wintrmut3/ECE496Hardware/CAD/drawing_1.png

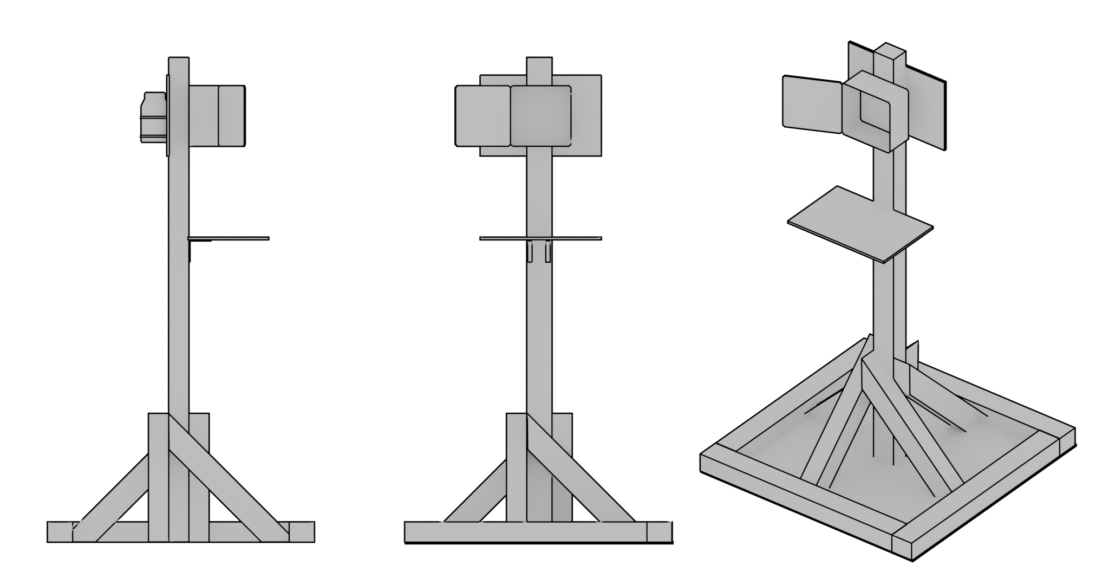
CAD/drawing_1.png
