wintrmut3/ECE496Hardware/(list of files, cad)

Other CAD files:
CAD/post_model.blend
