wintrmut3/ECE496Hardware/layout_v1.pdf

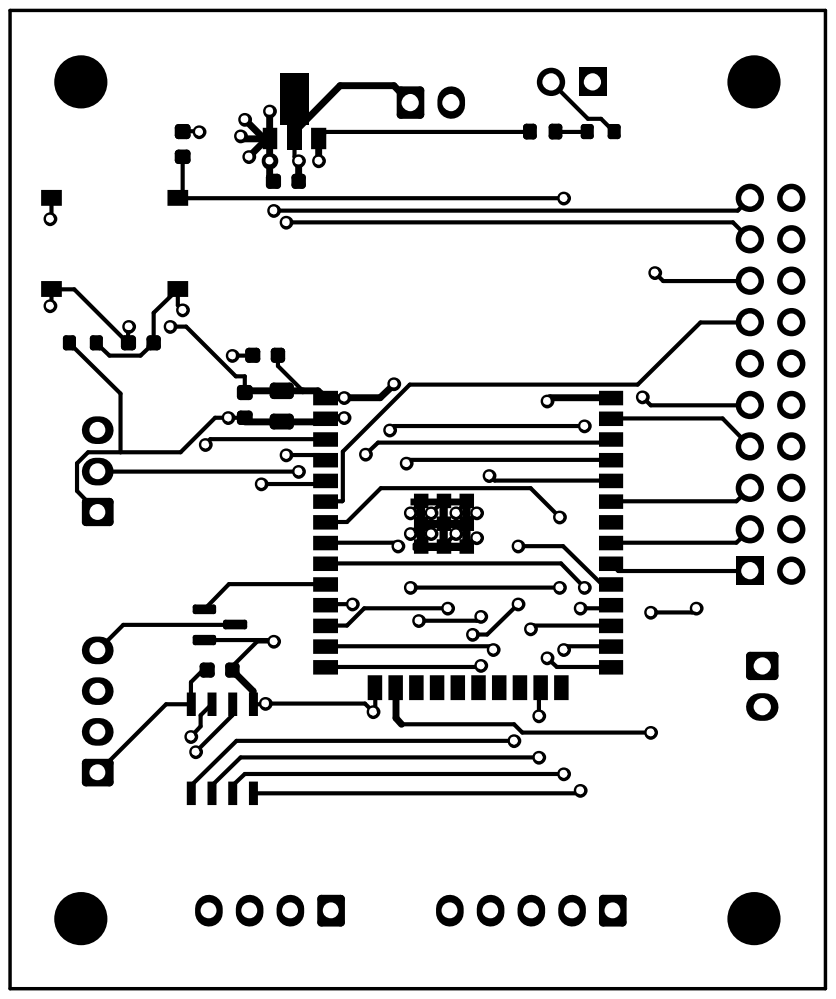
[picture p2: page 1]

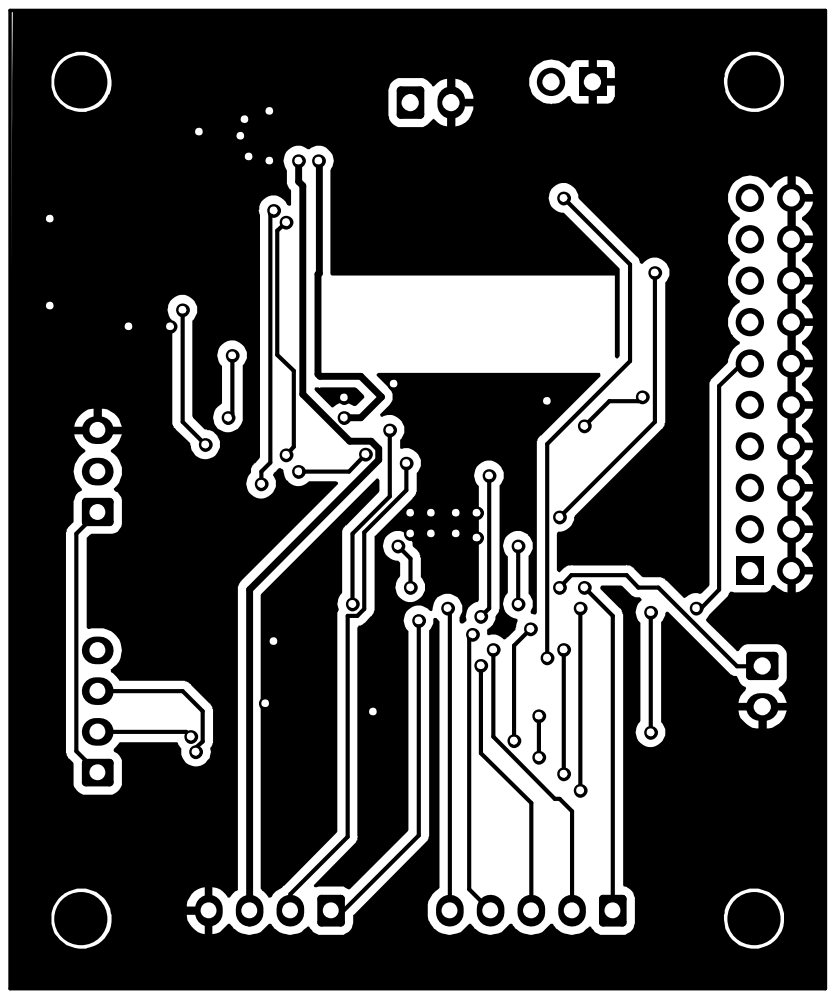
[picture p3: page 2]

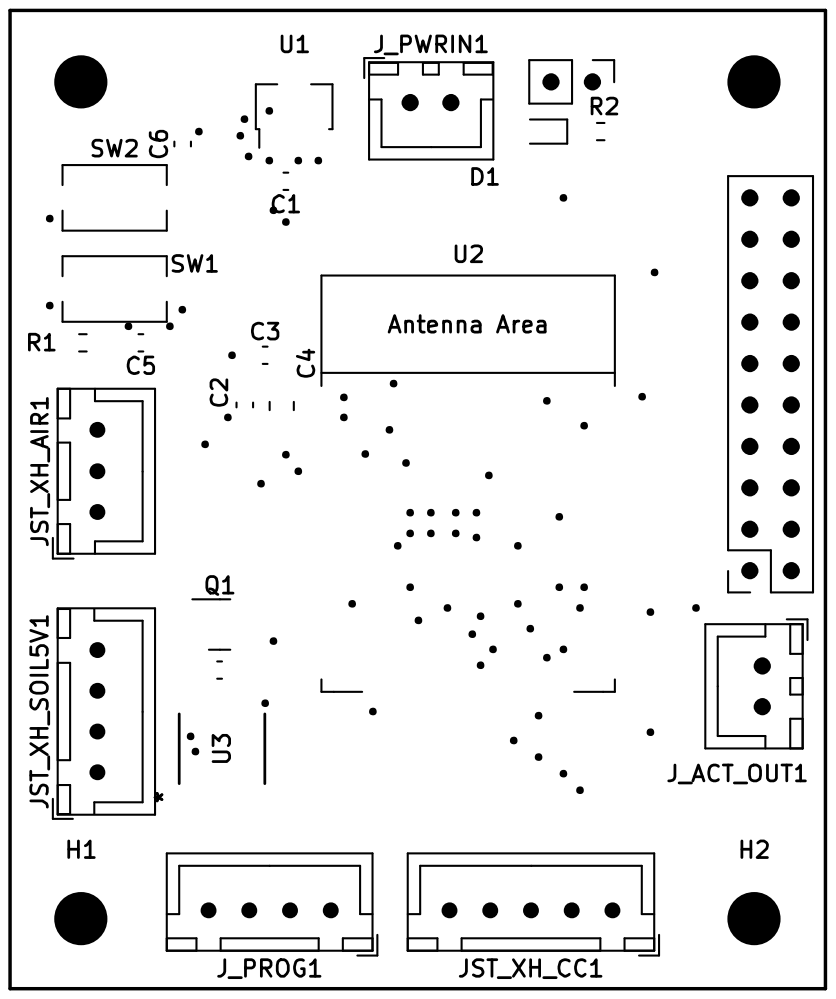
[picture p4: page 5]
