wintrmut3/ECE496Hardware/pcb_v1.pdf

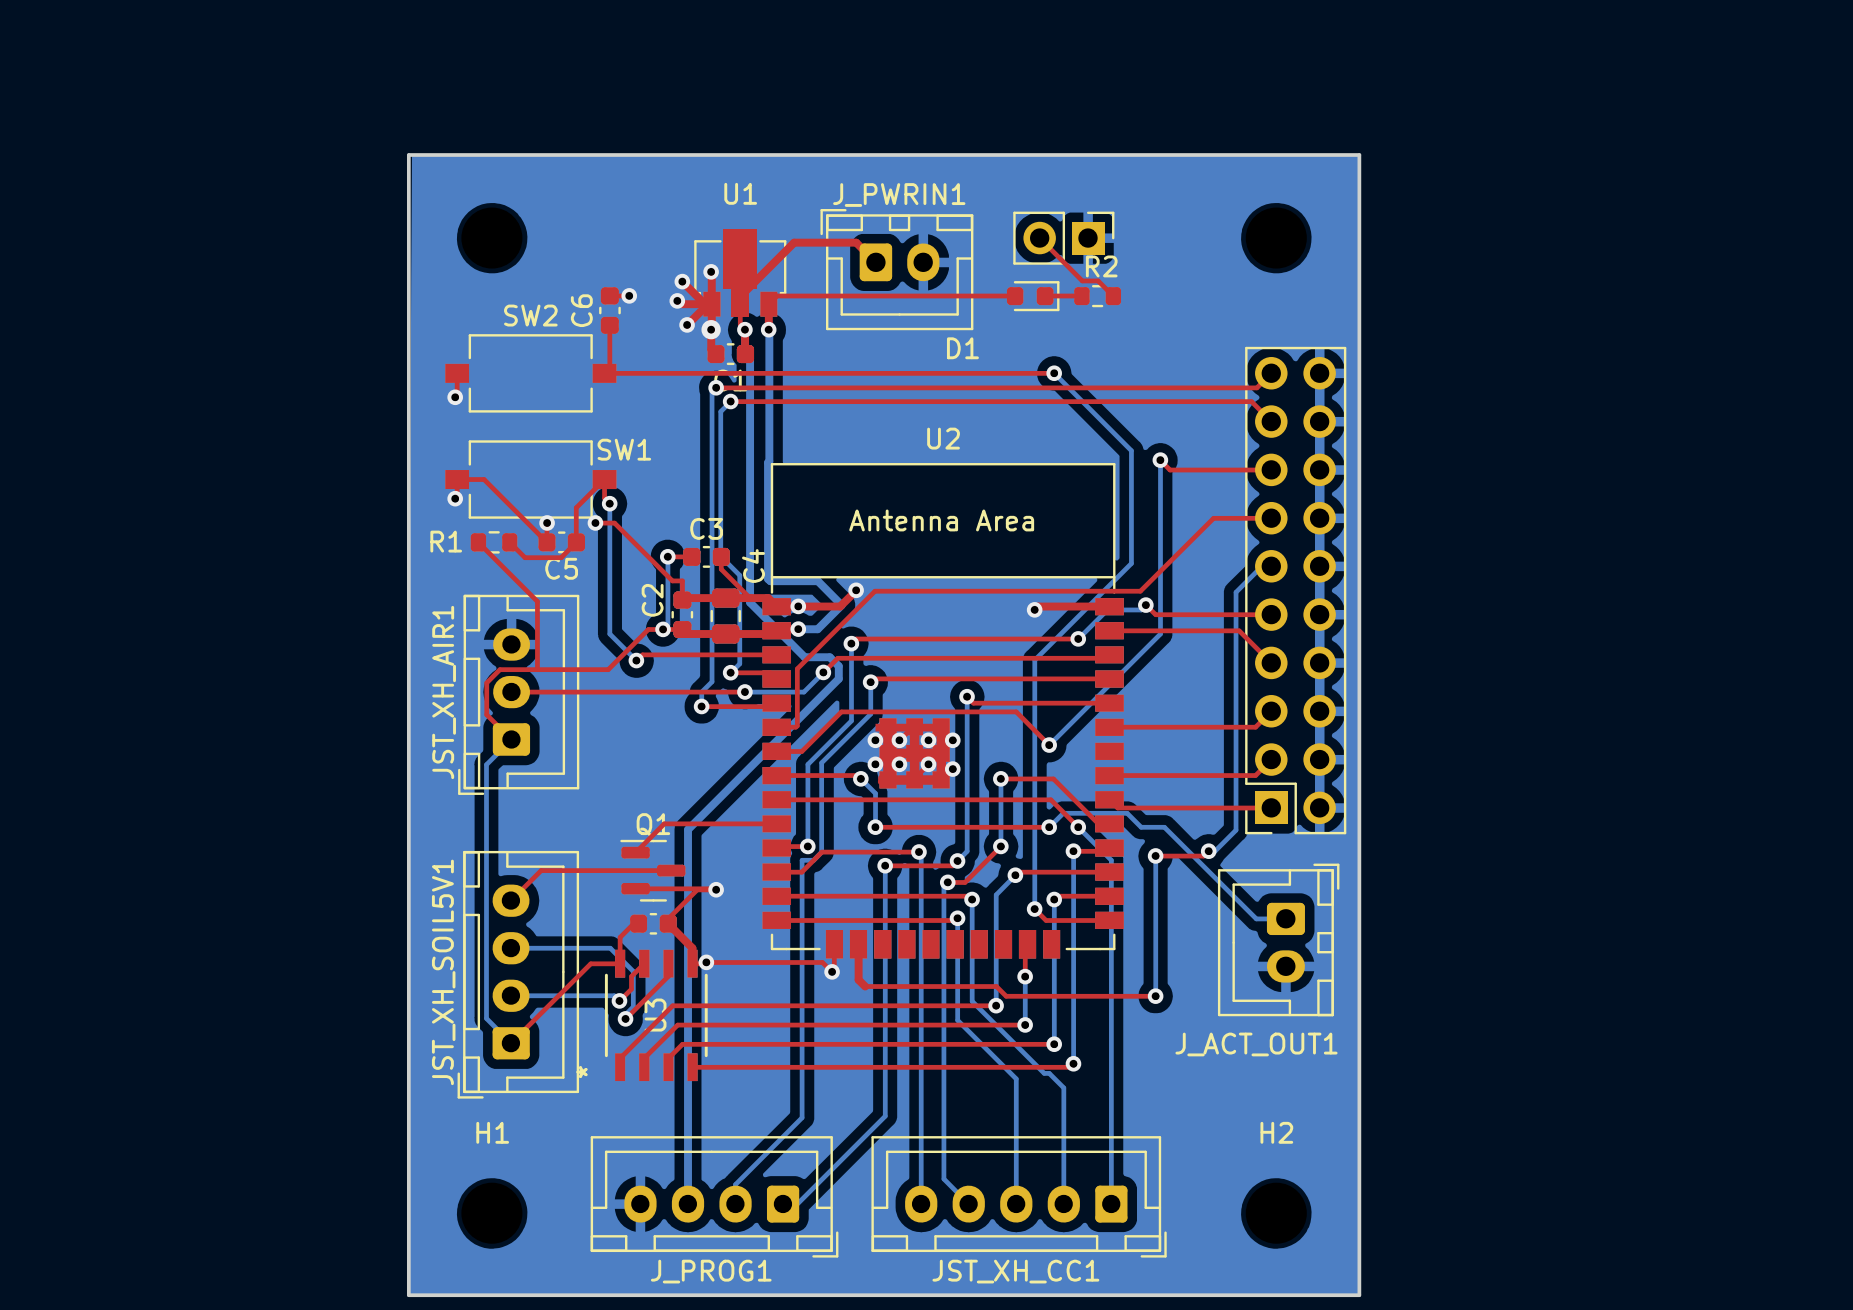
[picture p5: page 1]
