wintrmut3/ECE496Hardware/sch_v2.pdf

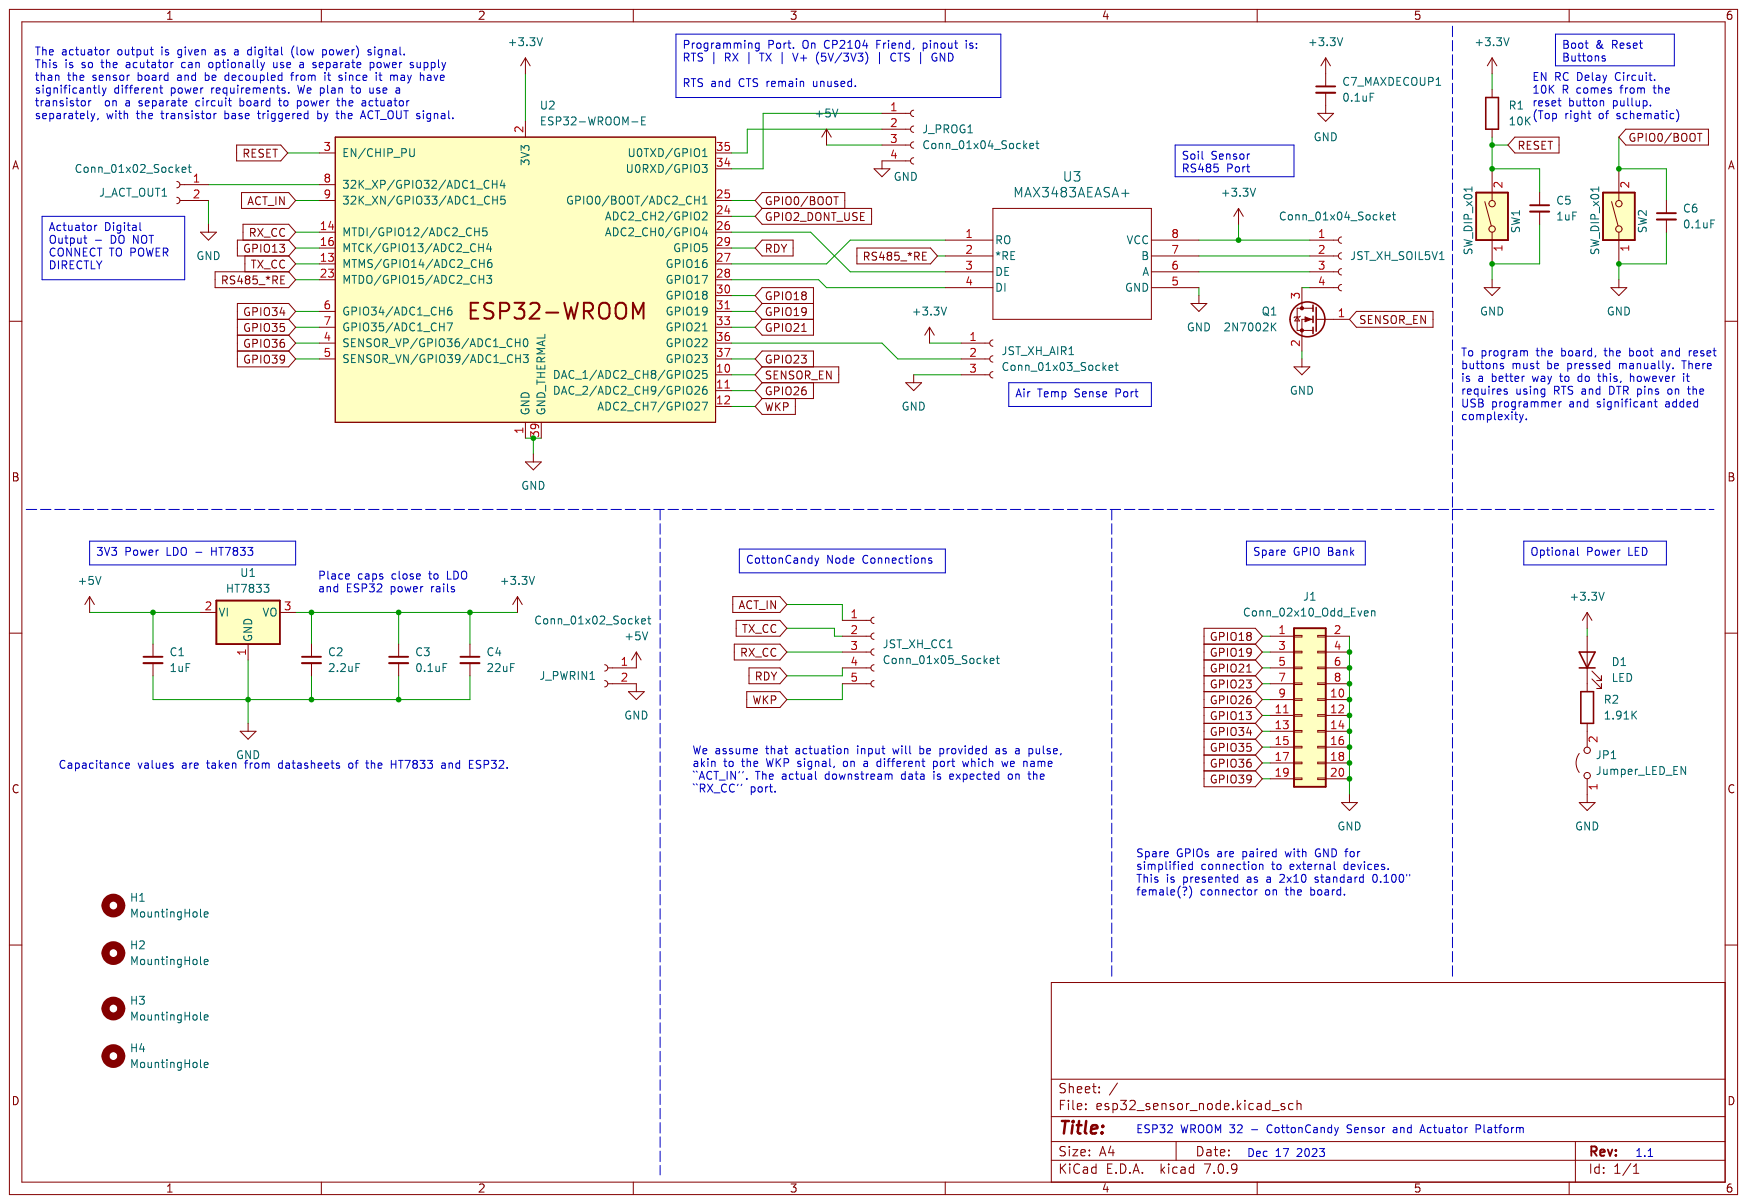
[picture p6: page 1]
