wintrmut3/ECE496Hardware/esp32_sensor_node_pcb/tmp.pdf

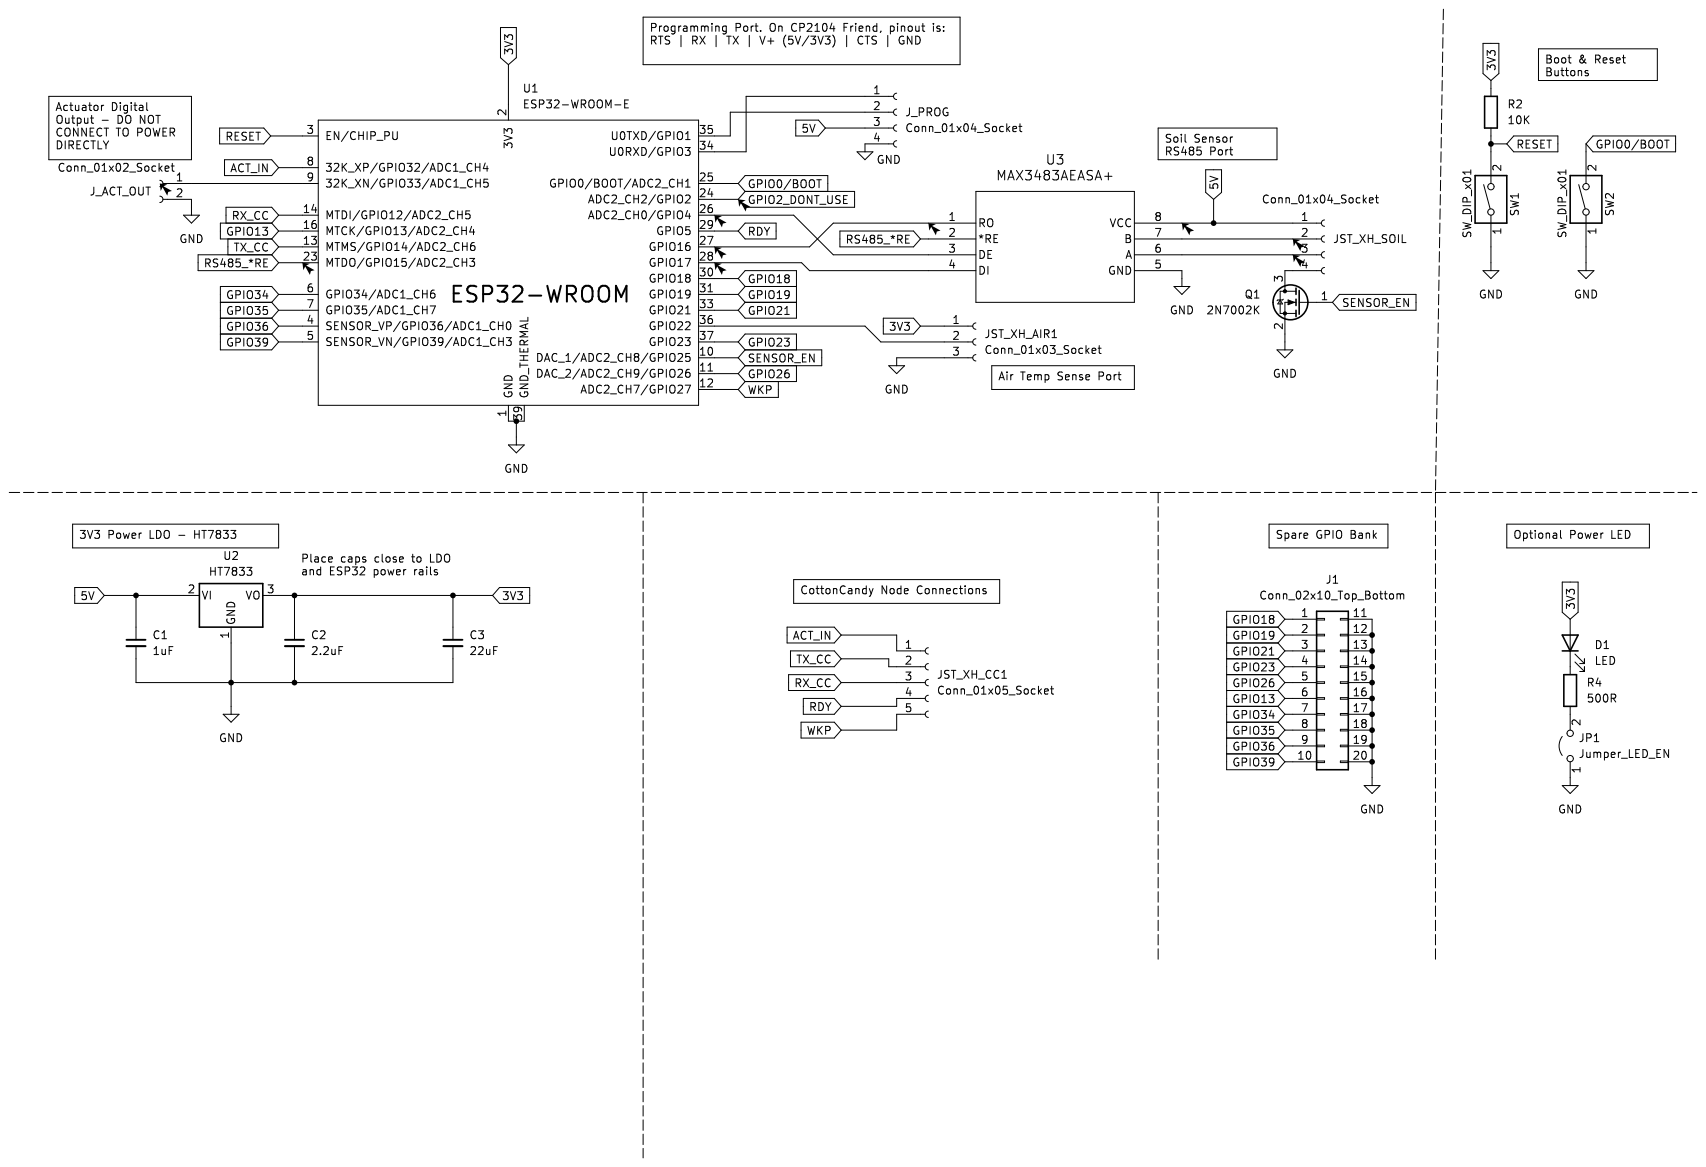
[picture p7: page 1]
