wintrmut3/ECE496Hardware/sch_v1.pdf

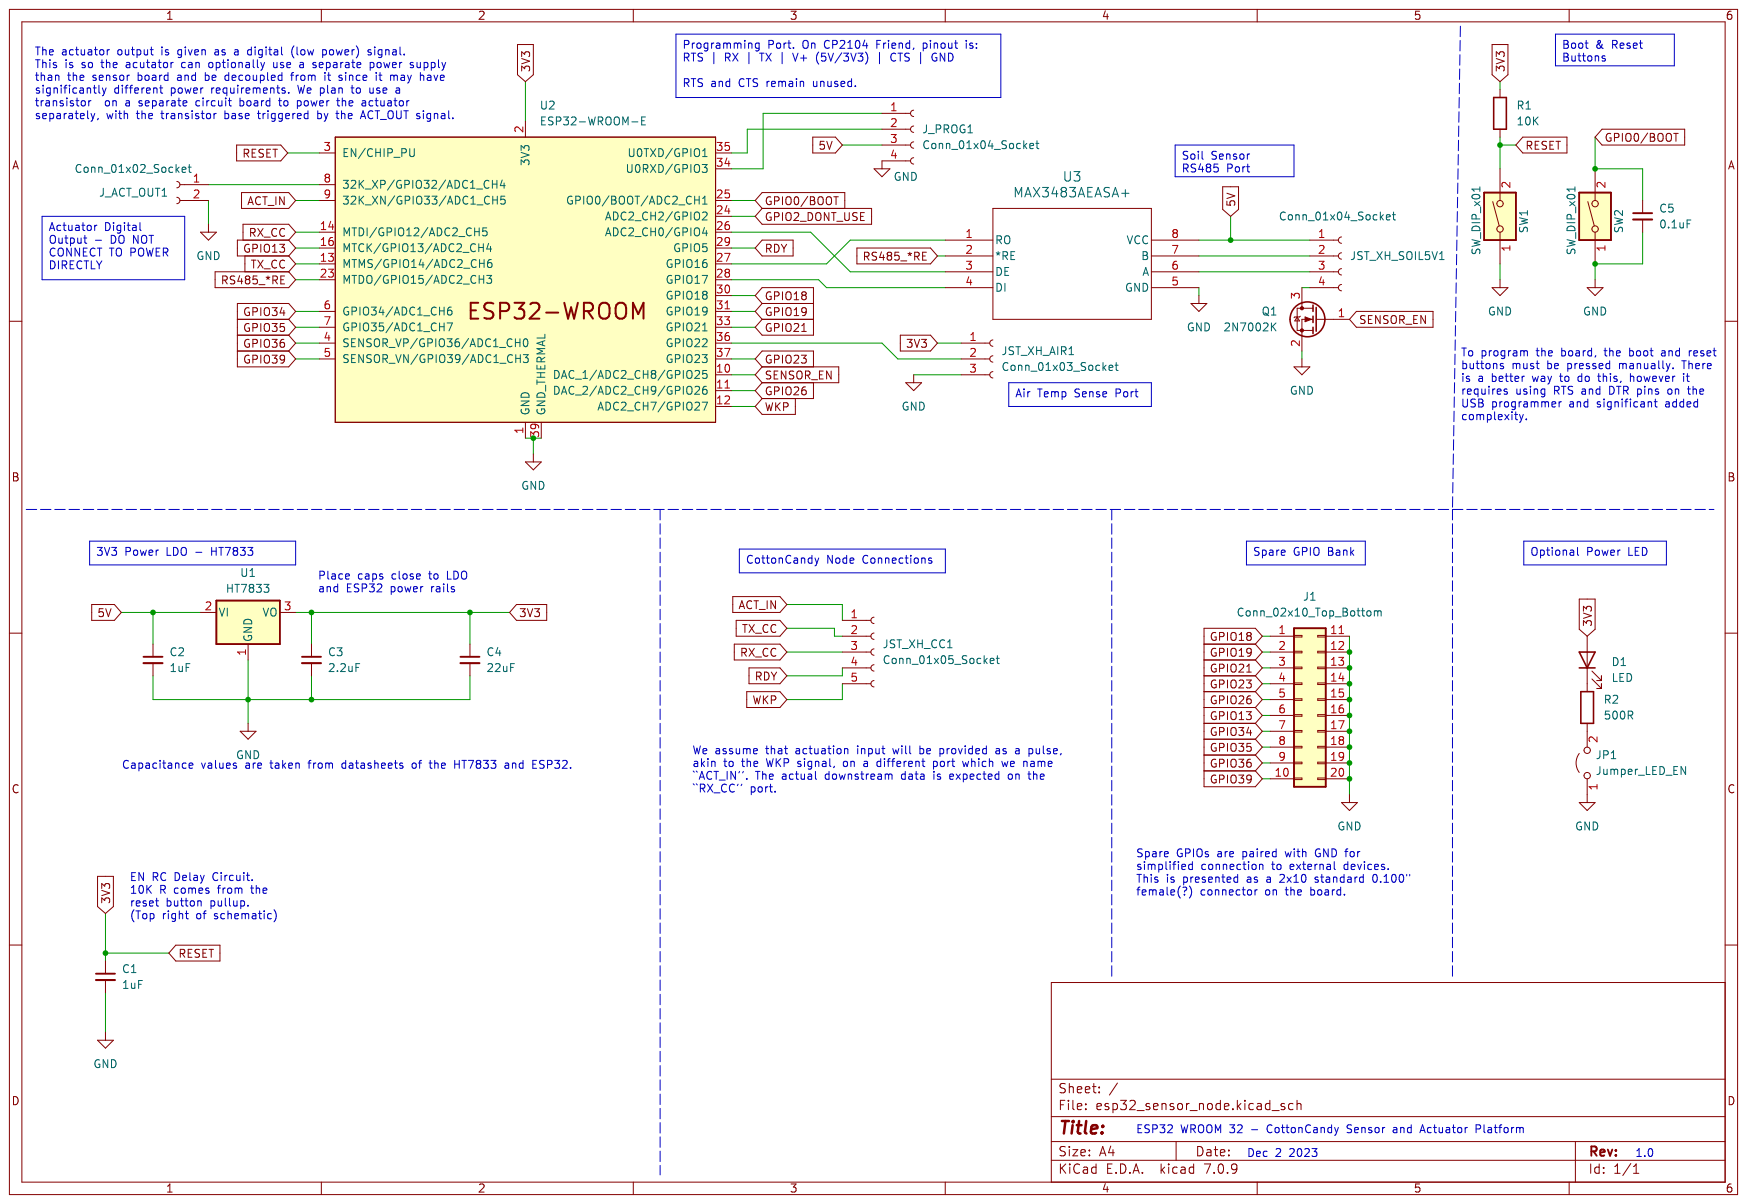
[picture p8: page 1]
