wintrmut3/ECE496Hardware/esp32_sensor_node_pcb/esp32_sensor_node.kicad_pcb

## KiCad design esp32_sensor_node_pcb/esp32_sensor_node.kicad_pcb (2023-12-28)

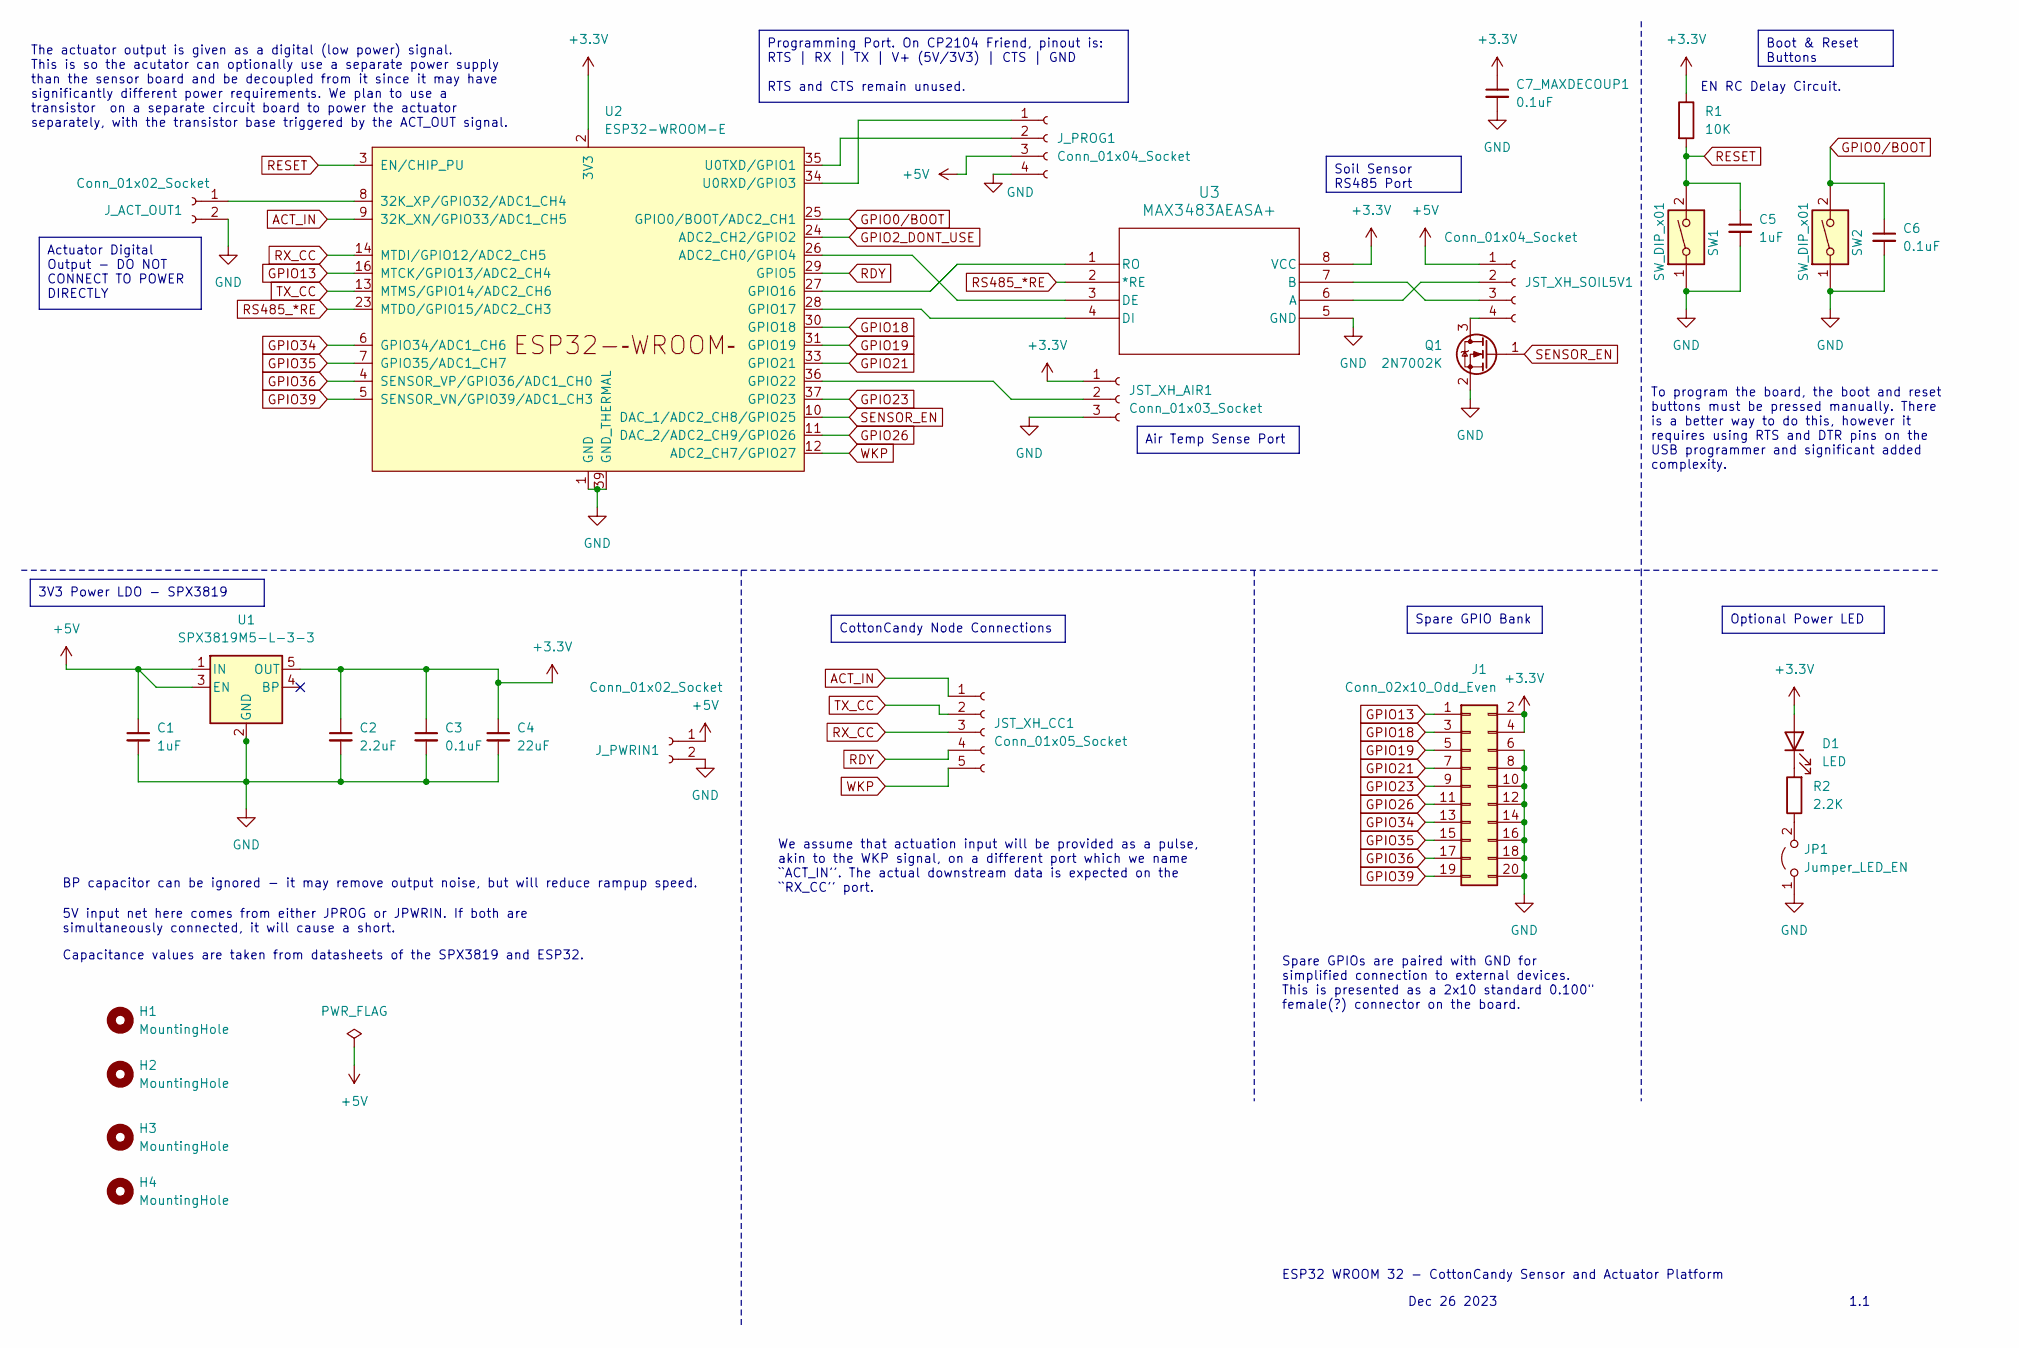
[picture p9: schematic esp32_sensor_node.kicad_sch]

Parts:
C1, C5: 1uF; C_0603_1608Metric
C2: 2.2uF; C_0805_2012Metric
C3, C6, C7_MAXDECOUP1: 0.1uF; C_0603_1608Metric
C4: 22uF; C_0805_2012Metric
D1: LED; LED_0603_1608Metric
H1, H2, H3, H4: MountingHole; MountingHole_3.2mm_M3
J1: Conn_02x10_Odd_Even; PinSocket_2x10_P2.54mm_Vertical
JP1: Jumper_LED_EN; PinHeader_1x02_P2.54mm_Vertical
JST_XH_AIR1: Conn_01x03_Socket; JST_XH_B3B-XH-A_1x03_P2.50mm_Vertical
JST_XH_CC1: Conn_01x05_Socket; JST_XH_B5B-XH-A_1x05_P2.50mm_Vertical
JST_XH_SOIL5V1: Conn_01x04_Socket; JST_XH_B4B-XH-A_1x04_P2.50mm_Vertical
J_ACT_OUT1: Conn_01x02_Socket; JST_XH_B2B-XH-A_1x02_P2.50mm_Vertical
J_PROG1: Conn_01x04_Socket; PinSocket_1x04_P2.54mm_Vertical
J_PWRIN1: Conn_01x02_Socket; JST_XH_B2B-XH-A_1x02_P2.50mm_Vertical
Q1: 2N7002K; SOT-23
R1: 10K; R_0603_1608Metric
R2: 2.2K; R_0603_1608Metric
SW1, SW2: SW_DIP_x01; SW_Tactile_SPST_NO_Straight_CK_PTS636Sx25SMTRLFS
U1: SPX3819M5-L-3-3; SOT-23-5
U2: ESP32-WROOM-E; ESP32-WROOM-32E
U3: MAX3483AEASA+; 21-0041B_8_MXM

Connections:
+3.3V: C2.1, C3.1, C4.1, C7_MAXDECOUP1.1, D1.2 (A), J1.2, J1.4, JST_XH_AIR1.1, R1.1, U1.5 (OUT), U2.2 (3V3), U3.8 (VCC)
+5V: C1.1, JST_XH_SOIL5V1.1, J_PROG1.3, J_PWRIN1.1, U1.1 (IN), U1.3 (EN)
ACT_IN: JST_XH_CC1.1, U2.9 (32K_XN/GPIO33/ADC1_CH5)
GND: C1.2, C2.2, C3.2, C4.2, C5.2, C6.2, C7_MAXDECOUP1.2, J1.6, J1.8, J1.10, J1.12, J1.14, J1.16, J1.18, J1.20, JP1.1 (A), JST_XH_AIR1.3, J_ACT_OUT1.2, J_PROG1.4, J_PWRIN1.2, Q1.2 (S), SW1.1, SW2.1, U1.2 (GND), U2.1 (GND), U2.15 (GND), U2.38 (GND), U2.39 (GND_THERMAL), U3.5 (GND)
GPIO0/BOOT: C6.1, SW2.2, U2.25 (GPIO0/BOOT/ADC2_CH1)
GPIO2_DONT_USE: U2.24 (ADC2_CH2/GPIO2)
GPIO13: J1.1, U2.16 (MTCK/GPIO13/ADC2_CH4)
GPIO18: J1.3, U2.30 (GPIO18)
GPIO19: J1.5, U2.31 (GPIO19)
GPIO21: J1.7, U2.33 (GPIO21)
GPIO23: J1.9, U2.37 (GPIO23)
GPIO26: J1.11, U2.11 (DAC_2/ADC2_CH9/GPIO26)
GPIO34: J1.13, U2.6 (GPIO34/ADC1_CH6)
GPIO35: J1.15, U2.7 (GPIO35/ADC1_CH7)
GPIO36: J1.17, U2.4 (SENSOR_VP/GPIO36/ADC1_CH0)
GPIO39: J1.19, U2.5 (SENSOR_VN/GPIO39/ADC1_CH3)
unnamed: D1.1 (K), R2.2
unnamed: JP1.2 (B), R2.1
unnamed: JST_XH_AIR1.2, U2.36 (GPIO22)
unnamed: JST_XH_SOIL5V1.2, U3.6 (A)
unnamed: JST_XH_SOIL5V1.3, U3.7 (B)
unnamed: JST_XH_SOIL5V1.4, Q1.3 (D)
unnamed: J_ACT_OUT1.1, U2.8 (32K_XP/GPIO32/ADC1_CH4)
unnamed: J_PROG1.1, U2.34 (U0RXD/GPIO3)
unnamed: J_PROG1.2, U2.35 (U0TXD/GPIO1)
unnamed: U2.26 (ADC2_CH0/GPIO4), U3.3 (DE)
unnamed: U2.27 (GPIO16), U3.1 (RO)
unnamed: U2.28 (GPIO17), U3.4 (DI)
RDY: JST_XH_CC1.4, U2.29 (GPIO5)
RESET: C5.1, R1.2, SW1.2, U2.3 (EN/CHIP_PU)
RS485_*RE: U2.23 (MTDO/GPIO15/ADC2_CH3), U3.2 (*RE)
RX_CC: JST_XH_CC1.3, U2.14 (MTDI/GPIO12/ADC2_CH5)
SENSOR_EN: Q1.1 (G), U2.10 (DAC_1/ADC2_CH8/GPIO25)
TX_CC: JST_XH_CC1.2, U2.13 (MTMS/GPIO14/ADC2_CH6)
WKP: JST_XH_CC1.5, U2.12 (ADC2_CH7/GPIO27)

Notes on the sheet:
Boot & Reset Buttons
3V3 Power LDO - SPX3819
Optional Power LED
Programming Port. On CP2104 Friend, pinout is: RTS | RX | TX | V+ (5V/3V3) | CTS | GND RTS and CTS remain unused.
Air Temp Sense Port
Soil Sensor RS485 Port
Actuator Digital Output - DO NOT CONNECT TO POWER DIRECTLY
CottonCandy Node Connections
Spare GPIO Bank
We assume that actuation input will be provided as a pulse, akin to the WKP signal, on a different port which we name ``ACT_IN''. The actual downstream data is expected on the ``RX_CC'' port.
To program the board, the boot and reset buttons must be pressed manually. There is a better way to do this, however it requires using RTS and DTR pins on the USB programmer and significant added complexity.
Capacitance values are taken from datasheets of the SPX3819 and ESP32.
BP capacitor can be ignored - it may remove output noise, but will reduce rampup speed.
Dec 26 2023
Spare GPIOs are paired with GND for simplified connection to external devices. This is presented as a 2x10 standard 0.100" female(?) connector on the board.
EN RC Delay Circuit.
1.1
ESP32 WROOM 32 - CottonCandy Sensor and Actuator Platform
5V input net here comes from either JPROG or JPWRIN. If both are simultaneously connected, it will cause a short.
The actuator output is given as a digital (low power) signal. This is so the acutator can optionally use a separate power supply than the sensor board and be decoupled from it since it may have significantly different power requirements. We plan to use a transistor on a separate circuit board to po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

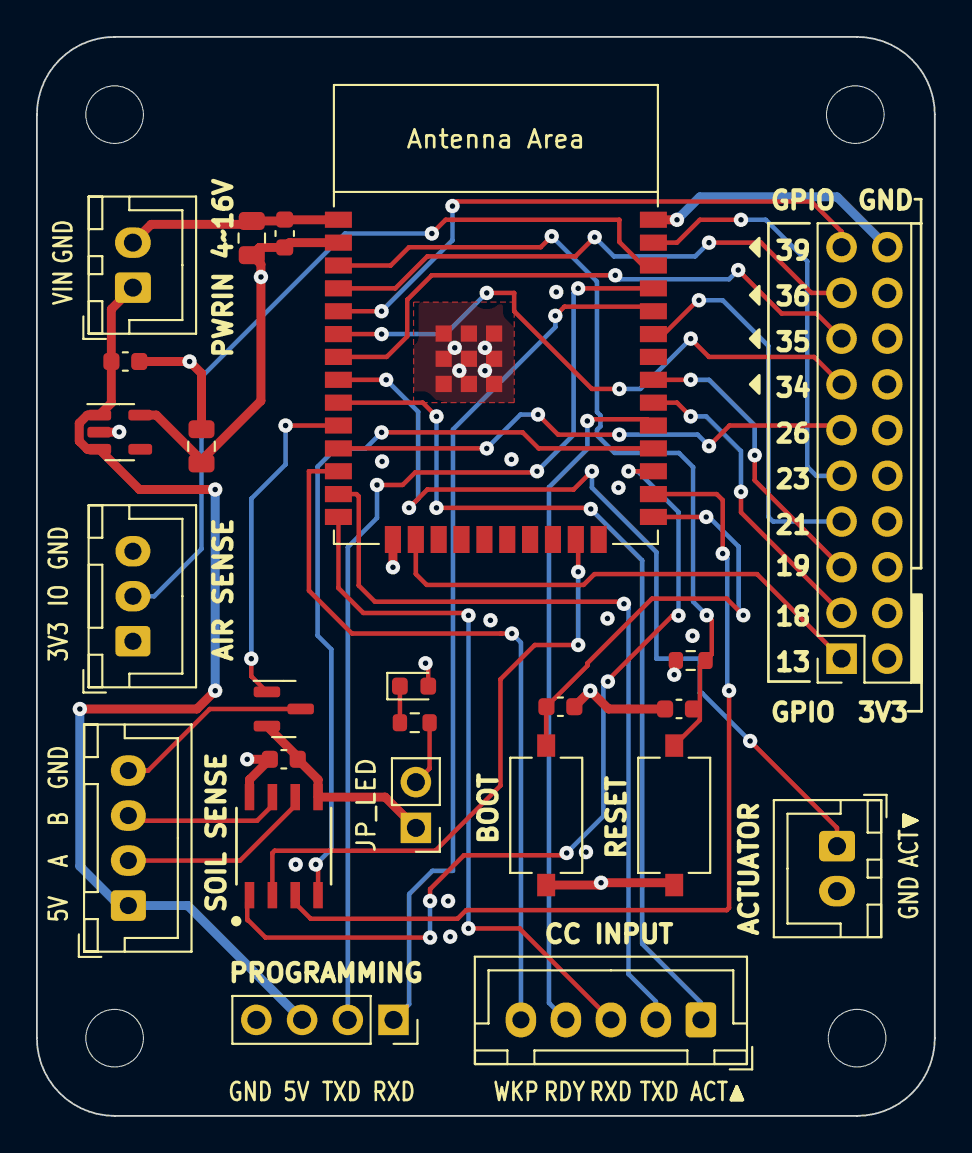
[picture p10: board esp32_sensor_node.kicad_pcb from above]

Board: 4 copper layers, 49.9 x 59.9 mm, 28 parts (0 on the bottom side), 34 nets.
