wintrmut3/ECE496Hardware/esp32_sensor_node_code/esp32_sensor_node_code.ino

/*  
    Copyright (C) 2023, Network Research Lab at the University of Toronto.

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
    You should have received a copy of the GNU General Public License along
    with this program; if not, write to the Free Software Foundation, Inc.,
    51 Franklin Street, Fifth Floor, Boston, MA 02110-1301 USA.

*/


// Include necessary libraries
#include <HardwareSerial.h>
#include "freertos/FreeRTOS.h"
#include "freertos/task.h"
#include "freertos/queue.h"
#include <OneWire.h>
#include <DallasTemperature.h>
#include <driver/adc.h>
#include <esp_wifi.h>
#include <ModbusMaster.h>
#include <Adafruit_GFX.h>
#include <Adafruit_SSD1306.h>
#include <Wire.h>

/**************************************************************************************************************************************************************/
//                                                          GLOBAL DECLARATIONS AND INITIALIZATIONS
/**************************************************************************************************************************************************************/

// Pin Definitions and other macros
#define RS485_DE 4
#define RS485_RE 15
#define ONE_WIRE_BUS 22
#define SENSOR_EN 25
#define RS485_GRD 26
#define ccWakeUp 27
#define ccReqData 5
#define MAX_BATCH_SIZE 50
#define ccRx 14
#define ccTx 12
#define RS485_Rx 16
#define RS485_Tx 17
#define actuateWakeUp 33
#define SAMPLE_SIZE 32 //size of the datapacket to be sent at once, so that data is not lost in fragmentation
#define AIR_TEMP 1
#define ACTUATE_INTENT 0x05
#define I2C_SDA 23
#define I2C_SCL 21

//Timeout Configuration
#define uS_TO_S_MULTIPLIER 1000000  
#define TIMEOUT_LIGHT_SLEEP  60 //change TIMEOUT_LIGHT_SLEEP for setting timeout in secs 
#define SENSOR_TIMEOUT 15000

#define SCREEN_WIDTH 128
#define SCREEN_HEIGHT 64
#define ACTUATE_TIME 2000


// Create instances of OneWire and DallasTemperature classes
OneWire oneWire(ONE_WIRE_BUS);
DallasTemperature sensors(&oneWire);
Adafruit_SSD1306 oled(SCREEN_WIDTH, SCREEN_HEIGHT, &Wire, -1);

// Global variables
uint8_t dataBufferSize = 0;     // Size of the packet
volatile bool isCollectionPhase = false;   // Flag indicating to make data collection active
QueueHandle_t msg_queue = xQueueCreate(15, sizeof(float));   // Message queue for storing data
volatile bool isTransmitPhase = false;  // Flag indicating to make data transmission active
unsigned int collectionCounter = 2;  // Counter for data collection, change to UINT_MAX for continuous collection
HardwareSerial SerialPort(1);
ModbusMaster node;
uint8_t myIntent = 0;


xTaskHandle xCollectionTask;   // Task handle for collecting data
xTaskHandle xTransmissionTask;   // Task handle for transmiting data

// Task Declarations
void TransmitLocalData(void *pvParameters);
void CollectLocalData(void *pvParameters);
// void actuatePump();

/**************************************************************************************************************************************************************/
//                                                                  End of Declarations
/**************************************************************************************************************************************************************/





/**************************************************************************************************************************************************************/
//                                                                    HELPER FUNCTIONS
/**************************************************************************************************************************************************************/
void actuatePump(uint8_t pin, uint8_t time_frac_16) {
  Serial.println("Actuating for ");
  Serial.print(ACTUATE_TIME/16 * time_frac_16);
  pinMode(pin, OUTPUT);
  digitalWrite(pin, HIGH);
  delay(ACTUATE_TIME/16 * time_frac_16);
  digitalWrite(pin, LOW);
}

// This function will convert any datatype to byte packets to transmit using UART
void send_bytes(void *val,int packet_size)
{
    
    byte* byte_ptr=(byte*)val;
    // For Debugging Purposes
    uint8_t i=0;
    while(i<packet_size){
      Serial.print(*(byte_ptr+i),HEX);
      Serial.print(".");
      i++;
    }
    Serial.println();
    SerialPort.write(byte_ptr,packet_size);
    SerialPort.flush();

}

// Sensor and IC control for power management
void disableMAX485()
{
    pinMode(RS485_RE,INPUT_PULLUP);
    pinMode(RS485_GRD,INPUT);
    pinMode(RS485_DE,INPUT);
}

void enableMAX485()
{
    pinMode(RS485_RE,INPUT_PULLDOWN);
    pinMode(RS485_GRD,INPUT_PULLUP); // should be pullup, for some reason this code is PD
    pinMode(RS485_DE,INPUT_PULLDOWN);
}

void enableSensor()
{
    pinMode(ONE_WIRE_BUS,INPUT_PULLUP);
    pinMode(SENSOR_EN,INPUT_PULLUP);
}

void disableSensor()
{
    pinMode(SENSOR_EN,INPUT_PULLDOWN);
}

void send_esp_to_deep_sleep()
{
    disableSensor();
    disableMAX485();
    pinMode(ccTx,INPUT);
    pinMode(ccRx,INPUT);
    esp_deep_sleep_start();
}

void esp_sleep_config_low_power()
{
    esp_sleep_pd_config(ESP_PD_DOMAIN_RTC_PERIPH,ESP_PD_OPTION_ON);
    esp_sleep_pd_config(ESP_PD_DOMAIN_RTC_SLOW_MEM, ESP_PD_OPTION_OFF);
    esp_sleep_pd_config(ESP_PD_DOMAIN_RTC_FAST_MEM, ESP_PD_OPTION_OFF);
    esp_sleep_pd_config(ESP_PD_DOMAIN_XTAL, ESP_PD_OPTION_OFF);
    esp_sleep_pd_config(ESP_PD_DOMAIN_VDDSDIO, ESP_PD_OPTION_OFF);
    
    gpio_pulldown_en((gpio_num_t)ccWakeUp);
    gpio_pulldown_en((gpio_num_t)ccReqData);
    gpio_pulldown_en((gpio_num_t)actuateWakeUp);

    gpio_wakeup_enable((gpio_num_t)ccReqData, GPIO_INTR_HIGH_LEVEL);
    esp_sleep_enable_ext1_wakeup(GPIO_SEL_27, ESP_EXT1_WAKEUP_ANY_HIGH);


    esp_sleep_enable_gpio_wakeup();
 
}

void send_esp_to_light_sleep()
{
    disableSensor();
    disableMAX485();
    esp_sleep_enable_timer_wakeup(TIMEOUT_LIGHT_SLEEP*uS_TO_S_MULTIPLIER);
    esp_light_sleep_start();
    check_wakeup_reason();
}

// User Defined function to collect data from sensors
uint8_t datacollect(float *humidity, float *soilTemperature, float *conductivity,float *temperature, float *pH, float *nitrogen, float *potassium, float *phosphorus) 
{
  // enabling the sensor and IC
  enableMAX485();
  delay(300);
  enableSensor();
  delay(300);

  if(AIR_TEMP) {
    // Collecting Dallas OneWire Temperature Sensor Data
    sensors.requestTemperatures(); 
    *temperature=((float)sensors.getTempCByIndex(0));
  }
  else {
    *temperature = 0;
  }
  


  // Collect Soil Sensor Data
  uint8_t result;

  Serial.println(F("Read MAX485 Node Registers"));
  unsigned long start=millis();
  while((unsigned long)(millis()-start)<SENSOR_TIMEOUT)//check if the sensor has booted and has collected the data or timeout
  {
    result = node.readHoldingRegisters(0x0000, 7);
    if (result == node.ku8MBSuccess)
    {
      *humidity = ((float)node.getResponseBuffer(0x00)) * ((float)0.1);
      *soilTemperature = ((float)node.getResponseBuffer(0x01)) * ((float)0.1);
      *conductivity = ((float)node.getResponseBuffer(0x02));
      *pH = ((float)node.getResponseBuffer(0x03))/10;
      *nitrogen = ((float)node.getResponseBuffer(0x04));
      *phosphorus = ((float)node.getResponseBuffer(0x05));
      *potassium = ((float)node.getResponseBuffer(0x06));
      
      // if(*pH>3 || (*soilTemperature != 0 && ((millis()-start) > SENSOR_TIMEOUT/2))) // Last thing to stabilize at ~15 seconds -- should get more consecutive readings
      // {
      //   Serial.println(F("Success, Received data"));
      //   break;
      // }
      // if(*soilTemperature>0) // Last thing to stabilize at ~15 seconds -- should get more consecutive readings
      // {
      //   Serial.println(F("Success, Received data"));
      //   break;
      // }
      // else delay(100);//wait for the sensor to bootup and load the values

    }
    else{
      Serial.println(result);
      Serial.println(F("Sensor didn't respond!"));
      Serial.flush();
      delay(500);//wait for the sensor to turn on
    }
    delay(100);
  }

  disableSensor();
  delay(500);
  disableMAX485();
  if(result==0)return 1;
  else return 0;
}

// For performing the wakeup stub
void check_wakeup_reason(){
  esp_sleep_wakeup_cause_t wakeup_reason;
  uint64_t wakeupBit;
  wakeup_reason = esp_sleep_get_wakeup_cause();
  Serial.println("Checking wakeup reason");

  switch(wakeup_reason)
  { 
    case ESP_SLEEP_WAKEUP_EXT1 : 
      Serial.println(F("Waking up the ESP from deep sleep!")); 
      Serial.flush();
      
      wakeupBit = esp_sleep_get_ext1_wakeup_status();
      if (wakeupBit & GPIO_SEL_33) {
        Serial.println("Selected pin 33");
        // actuatePump();
      }
      else if (wakeupBit & GPIO_SEL_27) {
        Serial.println("collection phase TRUE");
        isCollectionPhase=true;
      }     
      break;
    case ESP_SLEEP_WAKEUP_TIMER :
      Serial.println(F("Timed out, Going to deep sleep")); 
      Serial.flush();
      esp_sleep_disable_wakeup_source(ESP_SLEEP_WAKEUP_TIMER);
      send_esp_to_deep_sleep();
      break;
    
    case ESP_SLEEP_WAKEUP_GPIO:
      Serial.println(F("Waking up the ESP from Light Sleep")); 
      Serial.flush();
      esp_sleep_disable_wakeup_source(ESP_SLEEP_WAKEUP_TIMER);
      break;

    default : 
      Serial.println(F("Going to deep sleep\n"));
      Serial.flush();
      send_esp_to_deep_sleep(); 
      break;
  }
}


void sensor_init()
{
    Serial2.begin(4800, SERIAL_8N1, RS485_Rx, RS485_Tx);
    node.begin(1, Serial2);
    node.preTransmission(preTransmission);
    node.postTransmission(postTransmission); 
    sensors.begin();
}

void preTransmission()
{
  Serial.println("DE_HIGH");
  pinMode(RS485_DE, OUTPUT);
  digitalWrite(RS485_DE, HIGH);
  delay(100);
  // pinMode(RS485_DE, INPUT_PULLUP);
  pinMode(RS485_RE, INPUT_PULLUP);
  
}

void postTransmission()
{
  pinMode(RS485_RE, OUTPUT);
  digitalWrite(RS485_RE, LOW);
  pinMode(RS485_DE, INPUT_PULLDOWN);

  delay(500);
  
}



/**************************************************************************************************************************************************************/
//                                                                 End of Helper Functions
/**************************************************************************************************************************************************************/




/**************************************************************************************************************************************************************/
//                                                                     Main Programme
/**************************************************************************************************************************************************************/

void setup() {
  SerialPort.begin(9600, SERIAL_8N1, ccRx, ccTx);
  // pinMode(32, OUTPUT); // Actuation transistor output
  // delay(100);
  Serial.begin(115200);
  Wire.begin(I2C_SDA, I2C_SCL);
  unsigned long startTime = millis();
  // uint8_t myIntent;
  Serial.println("Before Reading Intent");
  while((unsigned long)(millis()-startTime) < 3000) {
    // Serial.print("time: ");
    // Serial.println(millis()-startTime);
    if(SerialPort.available()) {
      myIntent = (byte)SerialPort.read();
      Serial.print("Intent: ");
      Serial.println(myIntent, HEX); 
      break;
    }
    delay(10);
  }

  if (!oled.begin(SSD1306_SWITCHCAPVCC, 0x3C)) {
    Serial.println(F("SSD1306 allocation failed"));
    while (true) {
      Serial.println("SSD1306 allocation");
    }
  } 
  
  oled.clearDisplay(); //clear display
  delay(300);
  sensor_init();
  delay(100);
  esp_sleep_config_low_power();
  check_wakeup_reason();

  // should disable max chip on startup;
  disableMAX485();
  
  //If u get the freertos error for out of stack memory increase the stack size here
  xTaskCreatePinnedToCore(TransmitLocalData,"Communication",2048,NULL,1,&xTransmissionTask,0);
  xTaskCreatePinnedToCore(CollectLocalData,"Read_Sensor_Data",2048,NULL,1,&xCollectionTask,1);

}


void TransmitLocalData(void * pvParameters)
{
  
  while(1)
  {
    float value=0;
    bool isDataBufferEmpty=false;
    if(isTransmitPhase){
      while(!isDataBufferEmpty){
        if(dataBufferSize<=MAX_BATCH_SIZE)
        {
          uint8_t packetSize=dataBufferSize;
          send_bytes(&packetSize,1);   
          while(xQueueReceive(msg_queue, &value, (TickType_t)5)==pdPASS){
            send_bytes(&value,4);
            dataBufferSize=dataBufferSize-4;
          }
          Serial.print(packetSize);
          Serial.println(" packets sent");
          isDataBufferEmpty=true;
          break;
        }
        else
        {
          uint8_t packetSize=(MAX_BATCH_SIZE/SAMPLE_SIZE)*(SAMPLE_SIZE);
          send_bytes(&packetSize,1);
          for(int i=0;i<packetSize;i+=4)
          {
            if(xQueueReceive(msg_queue, &value, (TickType_t)5)==pdPASS)
            {
              send_bytes(&value,4);
              dataBufferSize=dataBufferSize-4;
            }
            else
            {
              dataBufferSize=0;
              isDataBufferEmpty=true;
              break;
            }
          }
        }
        if(!isDataBufferEmpty)send_esp_to_light_sleep(); 
      }

      if(collectionCounter<=0){
        Serial.println(F("Message Sent Going to deep sleep now"));
        Serial.flush();
        if(myIntent != 0) {
          // Extract a and b from c
          uint8_t a = (myIntent >> 4) & 0xF;
          uint8_t b = myIntent & 0xF;
          Serial.println("Actuating first pump");
          actuatePump(18, a);
          delay(500);
          Serial.println("Actuating second pump");
          actuatePump(19, b);
          myIntent = 0;
        }
        send_esp_to_deep_sleep();
      }
      else{
        isTransmitPhase=false;
        isCollectionPhase=true;
        vTaskResume(xCollectionTask);

      }
    }

    else vTaskSuspend(xTransmissionTask);

  }
  
}

void displayReading(float hum, float stemp, float cond, float temp, float pH, float nitrogen,float phosphorus, float potassium) {
  // Display values on OLED
            oled.clearDisplay(); //clear display
            oled.setTextSize(1);          // text size
            oled.setTextColor(WHITE);     // text color
            oled.setCursor(0, 0);
            oled.println("Air temp ");
            oled.setCursor(60, 0);
            oled.println(temp);

            oled.setCursor(0, 8);
            oled.println("Soil temp");
            oled.setCursor(60, 8);
            oled.println(stemp);

            oled.setCursor(0, 16);
            oled.println("Humidity");
            oled.setCursor(60, 16);
            oled.println(hum);

            oled.setCursor(0, 24);
            oled.println("cond");
            oled.setCursor(60, 24);
            oled.println(cond);

            oled.setCursor(0, 32);
            oled.println("pH ");
            oled.setCursor(60, 32);
            oled.println(pH);

            oled.setCursor(0, 40);
            oled.println("N");
            oled.setCursor(60, 40);
            oled.println(nitrogen);

            oled.setCursor(0, 48);
            oled.println("P");
            oled.setCursor(60, 48);
            oled.println(phosphorus);

            oled.setCursor(0, 56);
            oled.println("K");
            oled.setCursor(60, 56);
            oled.println(potassium);

            oled.display();
}


void CollectLocalData(void * pvParameters)
{
    dataBufferSize=0;
    while(1){
          if(collectionCounter==0)
          {
            Serial.println(F("No more sensor data to collect, going to sleep"));
            Serial.flush();
            send_esp_to_deep_sleep(); 
          }
          else if(collectionCounter==UINT_MAX);
          else collectionCounter--;
        
          unsigned long start=millis();
          while((unsigned long)(millis()-start)<SENSOR_TIMEOUT)
          {
            if(isCollectionPhase){
            
                float hum,temp,cond,stemp,pH,nitrogen, phosphorus, potassium;
                hum=0;
                temp=0;
                stemp=0;
                cond=0;
                pH=0;
                nitrogen=0;
                phosphorus=0;
                potassium=0;

                if(datacollect(&hum, &stemp, &cond, &temp, &pH, &nitrogen, &phosphorus, &potassium)){
                    Serial.print("Sending Sensor Data to queue [H sT C T pH N P K]: ");
                    Serial.print(hum);
                    Serial.print(" ");
                    Serial.print(stemp);
                    Serial.print(" ");
                    Serial.print(cond);
                    Serial.print(" ");
                    Serial.print(temp);
                    Serial.print(" ");
                    Serial.print(pH);
                    Serial.print(" ");
                    Serial.print(nitrogen);
                    Serial.print(" ");
                    Serial.print(phosphorus);
                    Serial.print(" ");
                    Serial.println(potassium);
                    Serial.flush();
                    xQueueSendToBack(msg_queue, &hum, (TickType_t)0);
                    xQueueSendToBack(msg_queue, &stemp, (TickType_t)0);
                    xQueueSendToBack(msg_queue, &cond, (TickType_t)0);
                    xQueueSendToBack(msg_queue, &temp, (TickType_t)0);
                    xQueueSendToBack(msg_queue, &pH, (TickType_t)0);
                    xQueueSendToBack(msg_queue, &nitrogen, (TickType_t)0);
                    xQueueSendToBack(msg_queue, &phosphorus, (TickType_t)0);
                    xQueueSendToBack(msg_queue, &potassium, (TickType_t)0);
                    dataBufferSize+=32;
                    displayReading(hum, stemp, cond, temp, pH, nitrogen, phosphorus, potassium);
                    break;
                }
            
            }
            
            else break;
          
          }



          isCollectionPhase=false;
          Serial.println("Going to light sleep");
          send_esp_to_light_sleep();
          isTransmitPhase=true;
          vTaskResume(xTransmissionTask);
          vTaskSuspend(xCollectionTask);
    }
}

void loop() {

}
/**************************************************************************************************************************************************************/
//                                                                 End of Main Programme
/**************************************************************************************************************************************************************/
