wintrmut3/ECE496Hardware/(commit log)

2023-12-03 Initial Push
    [esp32_sensor_node.csv, esp32_sensor_node.kicad_pcb, esp32_sensor_node.kicad_sch]
2023-12-03 Add remote BOM
    [BOM.csv]
2023-12-03 ESP32 code
2023-12-03 Update BOM.csv
    Add disclaimer to BOM for missing inconsequential components. These can be viewed on the PCB source.
    [BOM.csv]
2023-12-03 Update BOM.csv
    Replace .100" with 100 mil to allow pretty printing
    [BOM.csv]
2023-12-03 Update BOM.csv
    Remove excess commas for pretty printing
    [BOM.csv]
2023-12-17 Changed power symbols, added 0.1uF decoupling cap, changed LED resistor value to 1.91k as per part availability on JLPCB.
    [esp32_sensor_node.kicad_sch]
2023-12-17 Updated schematic
    [esp32_sensor_node.kicad_sch]
2023-12-17 Added big 0805 22u capacitor, fixed reset capacitor, add capacitor for max ic decoupling
    [esp32_sensor_node.kicad_pcb, esp32_sensor_node.kicad_sch]
2023-12-17 Add mounting holes
    [esp32_sensor_node.kicad_pcb, esp32_sensor_node.kicad_sch]
2023-12-18 Setup initial board layout
    [esp32_sensor_node.kicad_pcb, esp32_sensor_node.kicad_sch]
2023-12-18 Complete first draft routing
    [BOM.csv, esp32_sensor_node.kicad_pcb, esp32_sensor_node.kicad_sch]
2023-12-19 Add printouts
2023-12-24 Changed schematic - 3.3V to RS485, 5V to Soil sensor. Changed resistor from 1.9k to 4.7k. Finished routing of PCB with new schematic
    [esp32_sensor_node.kicad_pcb, esp32_sensor_node.kicad_sch]
2023-12-26 Add transfer vias for all HSS, remove some routing voids, standardize track lengths for power and signal
    [esp32_sensor_node.kicad_pcb, esp32_sensor_node.kicad_sch]
2023-12-26 Center MCU, reroute cleanup, add labels and shift components to fit
    [esp32_sensor_node.kicad_pcb, esp32_sensor_node.kicad_sch]
2023-12-26 Added constraints to board setup according to JLCPCB specifications for DRC checker. Arranged some text on silkscreen and some routing.
    [esp32_sensor_node.kicad_pcb]
2023-12-26 Add 3v3 outputs on header. Shift labels for alignment. Add board names on back.
    [esp32_sensor_node.kicad_pcb, esp32_sensor_node.kicad_sch]
2023-12-27 Change LDO HT7833 -> SPX3819, reroute, relabel. Generate BOM testing.
    [esp32_sensor_node.csv, esp32_sensor_node.kicad_pcb, esp32_sensor_node.kicad_sch, esp32_sensor_node_BOM.csv, esp32_sensor_node_BOM_empty.csv, esp32_sensor_node_BOM_some_lcsc.csv]
2023-12-27 Changed 2.2uF cap to 0805. Added power flag on 5V and not-connected for BP pin. Changed all vias to 0.3mm hole size. Changed programming interface to 2.54mm PIN headers.
    [esp32_sensor_node.kicad_pcb, esp32_sensor_node.kicad_sch]
2023-12-27 Removed reference designators on the silk screen
    [esp32_sensor_node.kicad_pcb]
2023-12-28 Add copyright & transfer vias. Checked ERC and DRC.
    [esp32_sensor_node.kicad_pcb]
2023-12-28 Add fab files. Add dot next to MAX3843 to indicate pin1
    [esp32_sensor_node-B_Cu.gbl, esp32_sensor_node-B_Mask.gbs, esp32_sensor_node-B_Paste.gbp, esp32_sensor_node-B_Silkscreen.gbo, esp32_sensor_node-Edge_Cuts.gm1, esp32_sensor_node-F_Cu.gtl, esp32_sensor_node-F_Mask.gts, esp32_sensor_node-F_Paste.gtp]
2024-01-17 - Add delays to RS485 and correct pullup direction on transistor (still need to add capacitance to ~RE) - Add digitalwrite + delay instead of input pullup on DE due to possible board fault (Input pul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
    [RS485_Tester_WorkingOnBoth.ino, esp32_sensor_node_code.ino]
2024-01-29 Updated ESP32 code with pH + NPK readings
2024-02-01 Adding CAD
    [post_model.blend]
2024-02-07 ESP32 with Intent working
2024-02-17 ESP32 code with intent not working
    [RS485_Tester_WorkingOnBoth.ino, esp32_sensor_node_code.ino]
2024-02-24 Pump + intent + pH readings
