wintrmut3/ECE496Hardware/(notices)

Notices in the files:
esp32_sensor_node_code/esp32_sensor_node_code.ino:
This program is free software; you can redistribute it and/or modify
it under the terms of the GNU General Public License as published by
the Free Software Foundation; either version 2 of the License, or
(at your option) any later version.
esp32_sensor_node_pcb/esp32_sensor_node.kicad_pcb:
Copyright © 2023 UofT Network Research Lab
